UltraColdLab/laser_current_controller/README.md

# laser_current_controller
laser current controller JILA
