UltraColdLab/laser_current_controller/current_controller_BOM.xlsx

Index | Attrition % | Requested Quantity 1 | Pack Quantity 1 | Pack Type 1 | Digi-Key Part Number 1 | Unit Price 1 | Extended Price 1 | Minimum Order Quantity 1 | Reference Designator | Product Notes
1 |  | 1 | 1 | Cut Tape (CT) | 490-4781-1-ND | 0.10000 | $0.10 | 1 | C1
2 |  | 5 | 5 | Cut Tape (CT) | 311-1445-1-ND | 0.10000 | $0.50 | 1 | C2, C10, C12, C18, C19
3 |  | 8 | 8 | Cut Tape (CT) | 1276-1935-1-ND | 0.10000 | $0.80 | 1 | C3, C4, C13, C14, C24, C25, C26, C27
4 |  | 4 | 4 | Cut Tape (CT) | 490-10991-1-ND | 0.48000 | $1.92 | 1 | C5, C6, C22, C23
5 |  | 2 | 2 | Cut Tape (CT) | 399-10312-1-ND | 2.12000 | $4.24 | 1 | C7, C8
6 |  | 2 | 2 | Cut Tape (CT) | 399-C0603C822K5RAC7867CT-ND | 0.10000 | $0.20 | 1 | C9, C21
7 |  | 6 | 6 | Cut Tape (CT) | 311-3470-1-ND | 0.63000 | $3.78 | 1 | C11, C16, C20, C28, C29, C30
8 |  | 1 | 1 | Cut Tape (CT) | 1276-6780-1-ND | 0.22000 | $0.22 | 1 | C15
9 |  | 3 | 3 | Cut Tape (CT) | 1655-1N4007FLCT-ND | 0.14000 | $0.42 | 1 | D1, D3, D5
10 |  | 2 | 2 | Cut Tape (CT) | 1N914BWTCT-ND | 0.17000 | $0.34 | 1 | D2, D4
11 |  | 1 | 1 | Bulk | A32260-ND | 5.39000 | $5.39 | 1 | J1
12 |  | 1 | 1 | Box | 277-1750-ND | 0.30000 | $0.30 | 1 | J2
13 |  | 1 | 1 | Bulk | A32260-ND | 5.39000 | $5.39 | 1 | J3
14 |  | 4 | 4 | Bulk | A32260-ND | 5.39000 | $21.56 | 1 | J4, J5, J6, J7
15 |  | 2 | 2 | Cut Tape (CT) | 732-1235-1-ND | 2.40000 | $4.80 | 1 | L1, L3
16 |  | 2 | 2 | Cut Tape (CT) | 495-5657-1-ND | 1.43000 | $2.86 | 1 | L2, L4
17 |  | 1 | 1 | Cut Tape (CT) | SMBT3906E6327HTSA1CT-ND | 0.36000 | $0.36 | 1 | Q1
18 |  | 1 | 15000 | Bulk | 2156-SMBT3904B5000-ND | 0.02000 | $300.00 | 15000 | Q2 | Non Cancellable Non Returnable. No Backorders Allowed. Marketplace Product. A separate shipping fee may apply.
19 |  | 1 | 1 | Cut Tape (CT) | NDS0605CT-ND | 0.36000 | $0.36 | 1 | Q3
20 |  | 1 | 1 | Cut Tape (CT) | 2N7002KCT-ND | 0.34000 | $0.34 | 1 | Q4
21 |  | 9 | 9 | Cut Tape (CT) | RG20P10.0KBCT-ND | 0.16000 | $1.44 | 1 | R1, R2, R8, R14, R15, R16, R17, R18, R38
22 |  | 9 | 9 | Cut Tape (CT) | P1.0KDACT-ND | 0.13000 | $1.17 | 1 | R3, R12, R23, R24, R26, R27, R28, R29, R30
23 |  | 2 | 2 | Cut Tape (CT) | 541-4.99CCCT-ND | 0.10000 | $0.20 | 1 | R4, R21
24 |  | 2 | 2 | Cut Tape (CT) | 749-MCU08050D5002BP100CT-ND | 0.85000 | $1.70 | 1 | R5, R20 | No Backorders Allowed.
25 |  | 2 | 2 | Cut Tape (CT) | 311-274CRCT-ND | 0.10000 | $0.20 | 1 | R6, R9
26 |  | 1 | 1 | Cut Tape (CT) | 541-10MAZCT-ND | 0.30000 | $0.30 | 1 | R7
27 |  | 2 | 2 | Cut Tape (CT) | RNCP0805FTD7K50CT-ND | 0.10000 | $0.20 | 1 | R10, R33
28 |  | 2 | 2 | Cut Tape (CT) | RG20P2.0KBCT-ND | 0.21000 | $0.42 | 1 | R11, R19
29 |  | 1 | 1 | Cut Tape (CT) | P3.0KDACT-ND | 0.13000 | $0.13 | 1 | R13
30 |  | 4 | 4 | Cut Tape (CT) | RMCF0805ZT0R00CT-ND | 0.10000 | $0.40 | 1 | R22, R34, R37, R40
31 |  | 2 | 2 | Cut Tape (CT) | RG20P100BCT-ND | 0.16000 | $0.32 | 1 | R31, R39
32 |  | 1 | 1 | Cut Tape (CT) | 13-RT0805BRD0743RLCT-ND | 0.16000 | $0.16 | 1 | R32
33 |  | 1 | 1 | Bulk | 987-1541-ND | 35.12000 | $35.12 | 1 | R42
34 |  | 2 | 2 | Bulk | 3590P-2-502L-ND | 20.52000 | $41.04 | 1 | R43, R44
35 |  | 1 | 1 | Tray | 804-1191-ND | 22.05000 | $22.05 | 1 | R45
36 |  | 3 | 3 | Bulk | EG2362-ND | 4.00000 | $12.00 | 1 | SW1, SW2, SW3
37 |  | 1 | 1 | Cut Tape (CT) | LM317EMP/NOPBCT-ND | 1.91000 | $1.91 | 1 | U1
38 |  | 3 | 3 | Cut Tape (CT) | OP27GSZ-REELCT-ND | 4.26000 | $12.78 | 1 | U2, U9, U10
39 |  | 1 | 1 | Cut Tape (CT) | LM337IMP/NOPBCT-ND | 2.32000 | $2.32 | 1 | U3
40 |  | 1 | 1 | Bag | 505-LM399AH#PBF-ND | 18.60000 | $18.60 | 1 | U5
41 |  | 2 | 2 | Cut Tape (CT) | LT1028CS8#TRPBFCT-ND | 13.64000 | $27.28 | 1 | U8, U11
42 |  | 1 | 1 | Box | 277-1707-ND | 0.80000 | $0.80 | 1 | X1
43 |  | 1 | 1 | Bulk | 804-1090-ND | 52.92000 | $52.92 | 1 | X2
44 |  | 1 | 1 | Cut Tape (CT) | SSM3K341RLFCT-ND | 0.43000 | $0.43 | 1 | X3
45 |  | 1 | 1 | Cut Tape (CT) | SSM3J168FLFCT-ND | 0.36000 | $0.36 | 1 | X4
