UltraColdLab/laser_current_controller/current_controller.kicad_pcb

## KiCad design current_controller.kicad_pcb (2024-05-06)

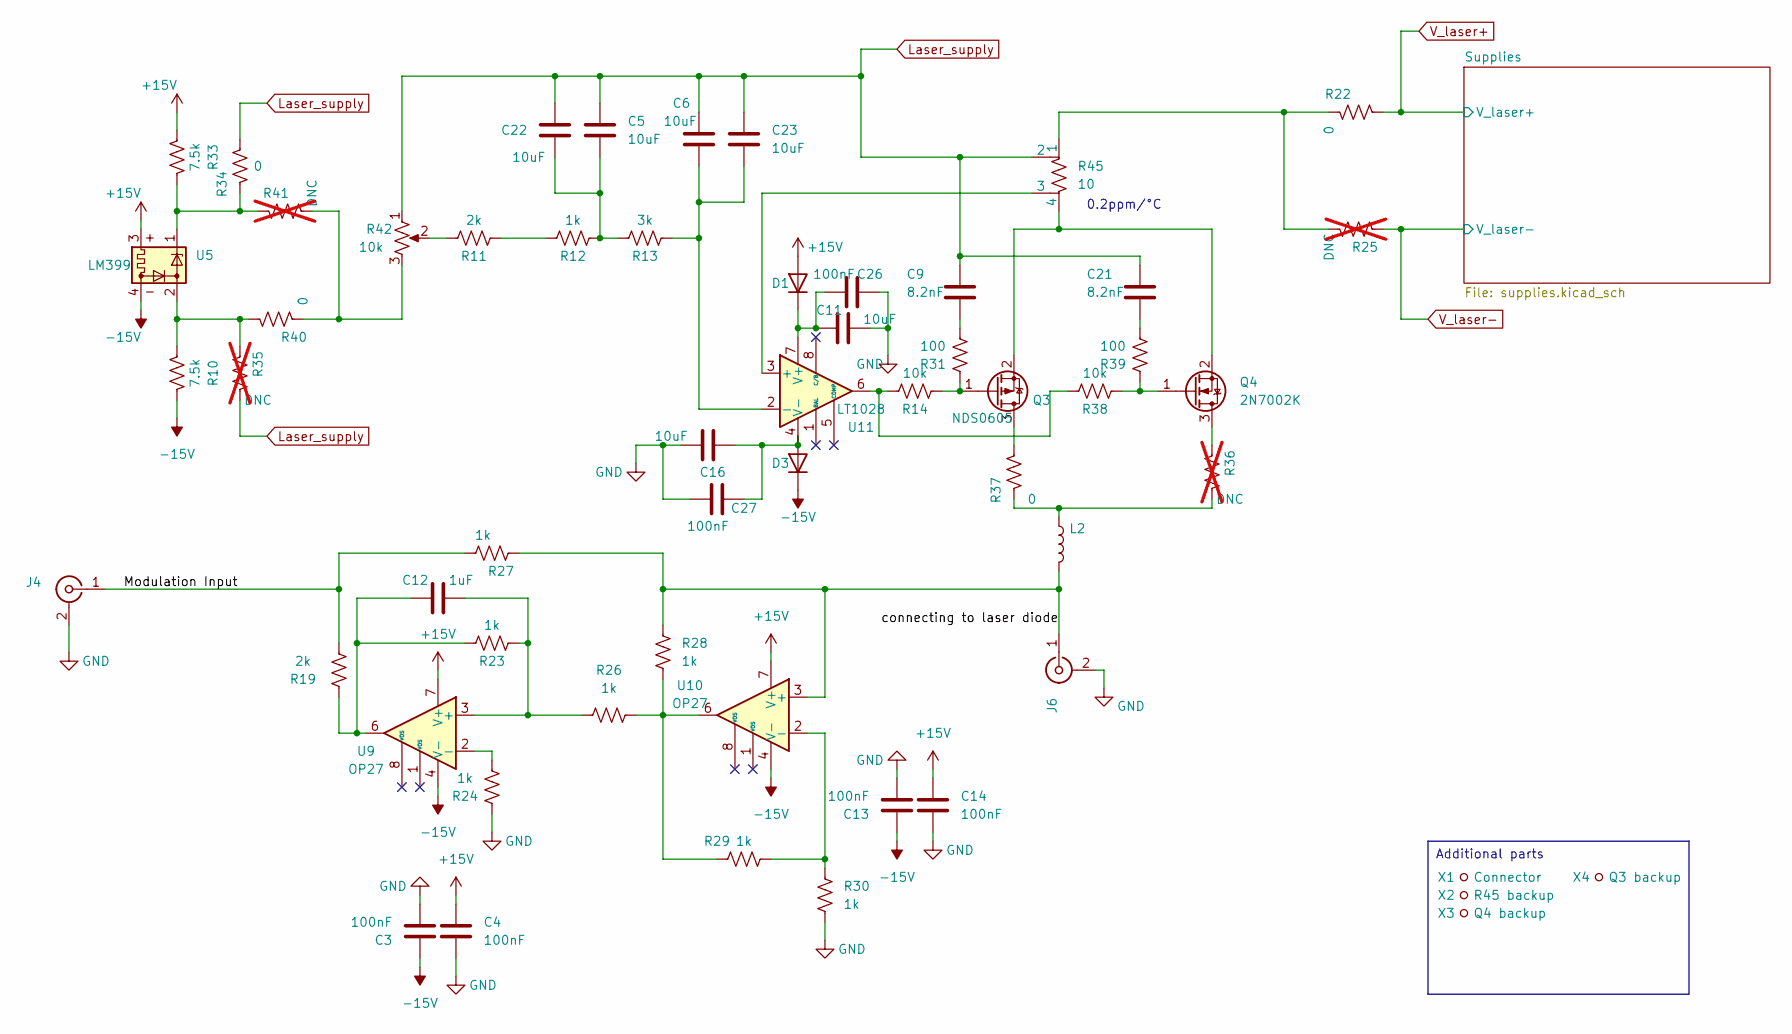
[picture p1: schematic current_controller.kicad_sch]

Parts:
C3, C4, C13, C14, C26, C27: 100nF; C_0603_1608Metric; MPN CL10B104KB8NNWC; DIGIKEY 1276-1935-1-ND
C5, C6, C22, C23: 10uF; C_0603_1608Metric; MPN ZRB18AR61E106ME01L; DIGIKEY 490-10991-1-ND
C9, C21: 8.2nF; C_0603_1608Metric; MPN C0603C822K5RAC7867; DIGIKEY 399-C0603C822K5RAC7867CT-ND
C11, C16: 10uF; C_1210_3225Metric; MPN CC1210ZKY5V9BB106; DIGIKEY 311-3470-1-ND
C12: 1uF; C_0603_1608Metric; MPN CC0603KRX5R8BB105; DIGIKEY 311-1445-1-ND
D1, D3: 1N4007; D_SOD-123F; MPN 1N4007FL; DIGIKEY 1655-1N4007FLCT-ND
J4, J6: Modulation Input; BNC_Amphenol_B6252HB-NPP3G-50_Horizontal; MPN 5227161-7; DIGIKEY A32260-ND
L2: 100uH; Inductor_2220; MPN B82442T1104K050; DIGIKEY 495-5657-1-ND - Cut Tape (CT)
Q3: NDS0605; SOT-23-3; MPN NDS0605; DIGIKEY NDS0605CT-ND
Q4: 2N7002K; SOT-23-3; MPN 2N7002K; DIGIKEY 2N7002KCT-ND
R10, R33: 7.5k; R_0805_2012Metric; MPN RNCP0805FTD7K50; DIGIKEY RNCP0805FTD7K50CT-ND
R11, R19: 2k; R_0805_2012Metric; MPN RG2012P-202-B-T5; DIGIKEY RG20P2.0KBCT-ND
R12, R23, R24, R26, R27, R28, R29, R30: 1k; R_0805_2012Metric; MPN ERA-6AEB102V; DIGIKEY P1.0KDACT-ND
R13: 3k; R_0805_2012Metric; MPN ERA-6AEB302V; DIGIKEY P3.0KDACT-ND
R14, R38: 10k; R_0805_2012Metric; MPN RG2012P-103-B-T5; DIGIKEY RG20P10.0KBCT-ND
R22, R34, R37, R40: 0; R_0805_2012Metric; MPN RMCF0805ZT0R00; DIGIKEY RMCF0805ZT0R00CT-ND
R25, R35, R36, R41: DNC; R_0805_2012Metric; not fitted
R31, R39: 100; R_0805_2012Metric; MPN RG2012P-101-B-T5; DIGIKEY RG20P100BCT-ND
R42: 10k; Multi_turn_potentiometer; MPN 8146R10KL.25; DIGIKEY 987-1541-ND
R45: 10; 10 Ohms VPG Foil Resistors Y160610R0000D9W; MPN Y160610R0000D9W; DIGIKEY 804-1191-ND
U5: LM399; Analog_TO-46-4_ThermalShield; MPN LM399AH#PBF; DIGIKEY 505-LM399AH#PBF-ND
U9, U10: OP27; SOIC-8_3.9x4.9mm_P1.27mm; MPN OP27GSZ-REEL; DIGIKEY OP27GSZ-REELCT-ND
U11: LT1028; SOIC-8_3.9x4.9mm_P1.27mm; MPN LT1028CS8#TRPBF; DIGIKEY LT1028CS8#TRPBFCT-ND
X1: Connector; MPN 1984028; DIGIKEY 277-1707-ND
X2: R45 backup; TO-220-4_Horizontal_TabDown; MPN Y212350R0000B9L; DIGIKEY 804-1090-ND
X3: Q4 backup; SOT-23-3; MPN SSM3K341R,LF; DIGIKEY SSM3K341RLFCT-ND
X4: Q3 backup; SOT-23-3; MPN SSM3J168F,LF; DIGIKEY SSM3J168FLFCT-ND

Connections:
+15V: C4.1, C14.1, D1.2 (A), R33.2, U5.3, U9.7 (V+), U10.7 (V+); also elsewhere on the board
-15V: C3.1, C13.1, D3.1 (K), R10.1, U5.4, U9.4 (V-), U10.4 (V-); also elsewhere on the board
/Modulation Input: J4.1 (In), R19.2, R27.2
/connecting to laser diode: J6.1 (In), L2.2, R27.1, R28.2, U10.3 (+)
GND: C3.2, C4.2, C11.2, C13.2, C14.2, C16.2, C26.2, C27.1, J4.2 (Ext), J6.2 (Ext), R24.1, R30.1; also elsewhere on the board
Laser_supply: C5.1, C6.1, C9.1, C21.1, C22.2, C23.1, R34.1, R35.2, R42.1, R45.2
unnamed: C9.2, R31.2
unnamed: C12.1, R19.1, R23.1, U9.6
unnamed: C21.2, R39.2
unnamed: C5.2, C22.1, R12.2, R13.1
unnamed: C11.1, C26.1, D1.1 (K), U11.7 (V+)
unnamed: C16.1, C27.2, D3.2 (A), U11.4 (V-)
unnamed: L2.1, R36.2, R37.2
unnamed: Q3.3 (D), R37.1
unnamed: Q3.1 (G), R14.2, R31.1
unnamed: Q3.2 (S), Q4.2 (S), R45.4
unnamed: Q4.3 (D), R36.1
unnamed: Q4.1 (G), R38.2, R39.1
unnamed: R10.2, R35.1, R40.1, U5.2
unnamed: R11.1, R42.2
unnamed: R11.2, R12.1
unnamed: R14.1, R38.1, U11.6
unnamed: R22.2, R25.2, R45.1
unnamed: R26.2, R28.1, R29.1, U10.6
unnamed: R33.1, R34.2, R41.1, U5.1
unnamed: R40.2, R41.2, R42.3
unnamed: C12.2, R23.2, R26.1, U9.3 (+)
unnamed: R24.2, U9.2 (-)
unnamed: R29.2, R30.2, U10.2 (-)
unnamed: R45.3, U11.3 (+)
unnamed: C6.2, C23.2, R13.2, U11.2 (-)
V_laser+: R22.1; also elsewhere on the board
V_laser-: R25.1; also elsewhere on the board

Notes on the sheet:
Additional parts
0.2ppm/°C

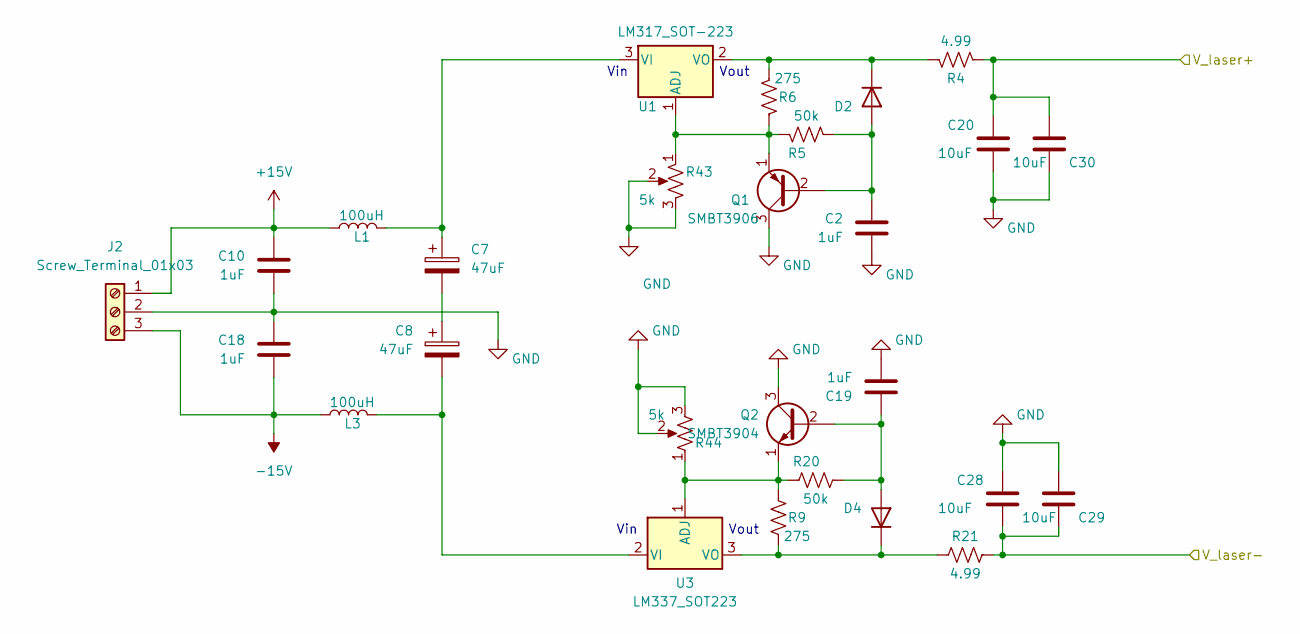
[picture p2: schematic supplies.kicad_sch]

Parts:
C2, C10, C18, C19: 1uF; C_0603_1608Metric; MPN CC0603KRX5R8BB105; DIGIKEY 311-1445-1-ND
C7, C8: 47uF; CP_EIA-3216-10_Kemet-I; MPN T495X476M035ATE300; DIGIKEY 399-10312-1-ND
C20, C28, C29, C30: 10uF; C_1210_3225Metric; MPN CC1210ZKY5V9BB106; DIGIKEY 311-3470-1-ND
D2, D4: 1N914WT; D_SOD-523F; MPN 1N914BWT; DIGIKEY 1N914BWTCT-ND
J2: Screw_Terminal_01x03; TerminalBlock_4Ucon_1x03_P3.50mm_Horizontal; MPN 1945106; DIGIKEY 277-1750-ND
L1, L3: 100uH; L_12x12mm_H8mm; MPN 74477020; DIGIKEY 732-1235-1-ND
Q1: SMBT3906; SOT-23-3; MPN SMBT3906E6327HTSA1; DIGIKEY SMBT3906E6327HTSA1CT-ND
Q2: SMBT3904; SOT-23-3; MPN MMBT3904_R1_00001; DIGIKEY 3757-MMBT3904_R1_00001CT-ND
R4, R21: 4.99; R_0805_2012Metric; MPN CRCW08054R99FKEA; DIGIKEY 541-4.99CCCT-ND
R5, R20: 50k; R_0805_2012Metric; MPN MCU08050D5002BP100; DIGIKEY 749-MCU08050D5002BP100CT-ND
R6, R9: 275; R_0805_2012Metric; MPN RC0805FR-07274RL; DIGIKEY 311-274CRCT-ND
R43, R44: 5k; Potentiometer_Bourns_3296W_Vertical; MPN 3296W-1-502LF; DIGIKEY 3296W-502LF-ND
U1: LM317_SOT-223; SOT-223-3_TabPin2; MPN LM317EMP/NOPB; DIGIKEY LM317EMP/NOPBCT-ND
U3: LM337_SOT223; SOT-223-3_TabPin2; MPN LM337IMP/NOPB; DIGIKEY LM337IMP/NOPBCT-ND

Connections:
+15V: C10.1, J2.1, L1.2; also elsewhere on the board
-15V: C18.2, J2.3, L3.2; also elsewhere on the board
GND: C2.2, C10.2, C18.1, C19.2, C20.2, C28.1, C29.1, C30.2, J2.2, Q1.3 (C), Q2.3 (C), R43.2, R43.3, R44.2, R44.3; also elsewhere on the board
unnamed: C7.2, C8.1
unnamed: C2.1, D2.2 (A), Q1.2 (B), R5.1
unnamed: D2.1 (K), R4.2, R6.2, U1.2 (VO)
unnamed: C19.1, D4.2 (A), Q2.2 (B), R20.1
unnamed: D4.1 (K), R9.2, R21.2, U3.3 (VO)
unnamed: Q1.1 (E), R5.2, R6.1, R43.1, U1.1 (ADJ)
unnamed: Q2.1 (E), R9.1, R20.2, R44.1, U3.1 (ADJ)
unnamed: C7.1, L1.1, U1.3 (VI)
unnamed: C8.2, L3.1, U3.2 (VI)
V_laser+: C20.1, C30.1, R4.1; also elsewhere on the board
V_laser-: C28.2, C29.2, R21.1; also elsewhere on the board

Notes on the sheet:
Vout
Vin

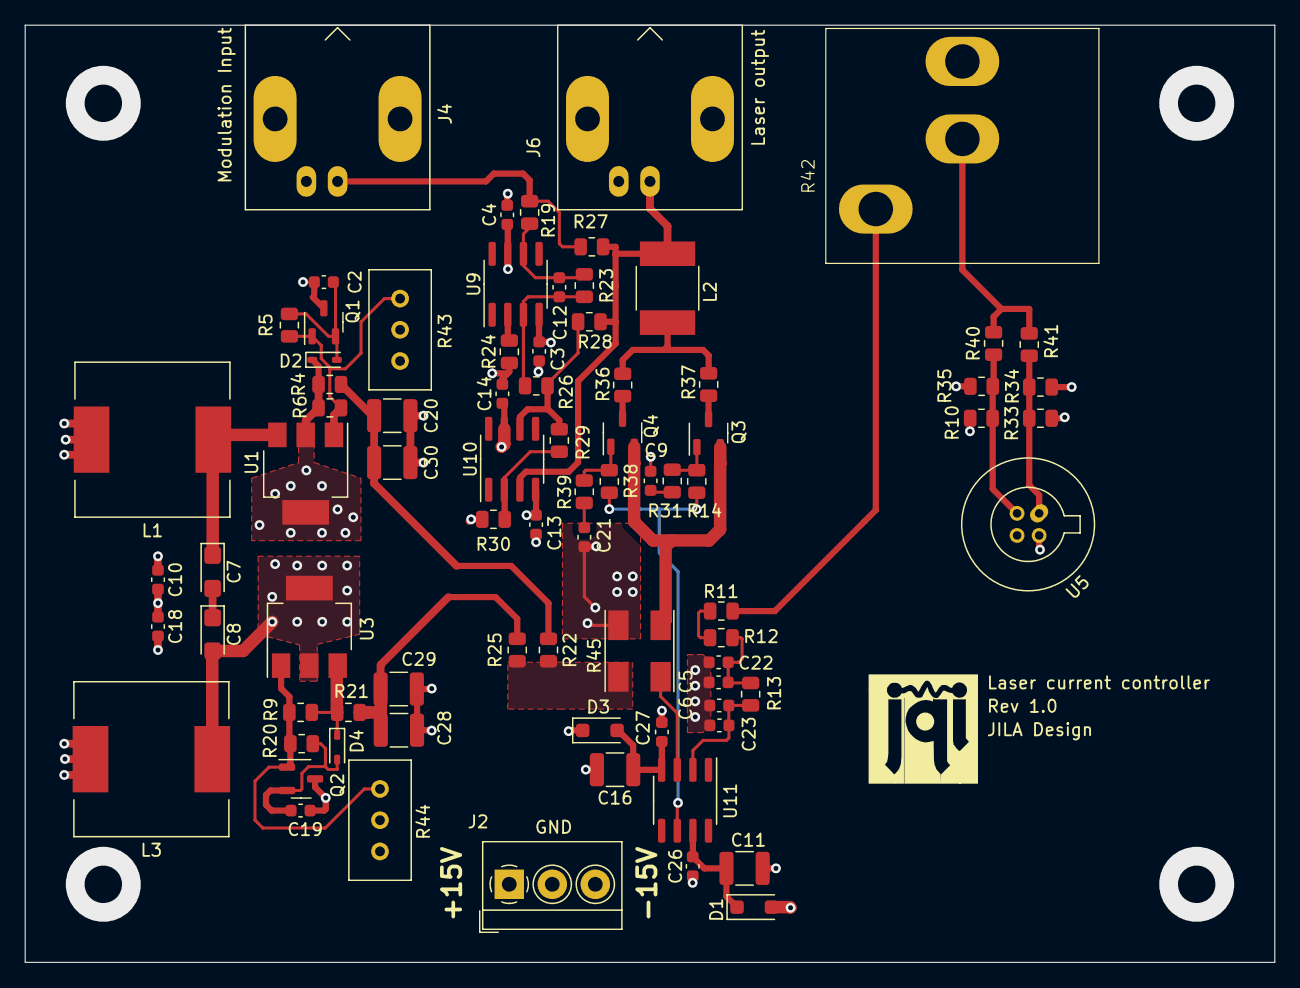
[picture p3: board current_controller.kicad_pcb from above]

Board: 4 copper layers, 101.6 x 76.2 mm, 81 parts (0 on the bottom side), 42 nets.

Other parts of the board:
U$3: JQI_LOGO_NEGATIVE-SILKSCREEN
